sebouh137/KiCadProjects/PrototypeSingleHexTileLarge_6mmSiPM/front.png

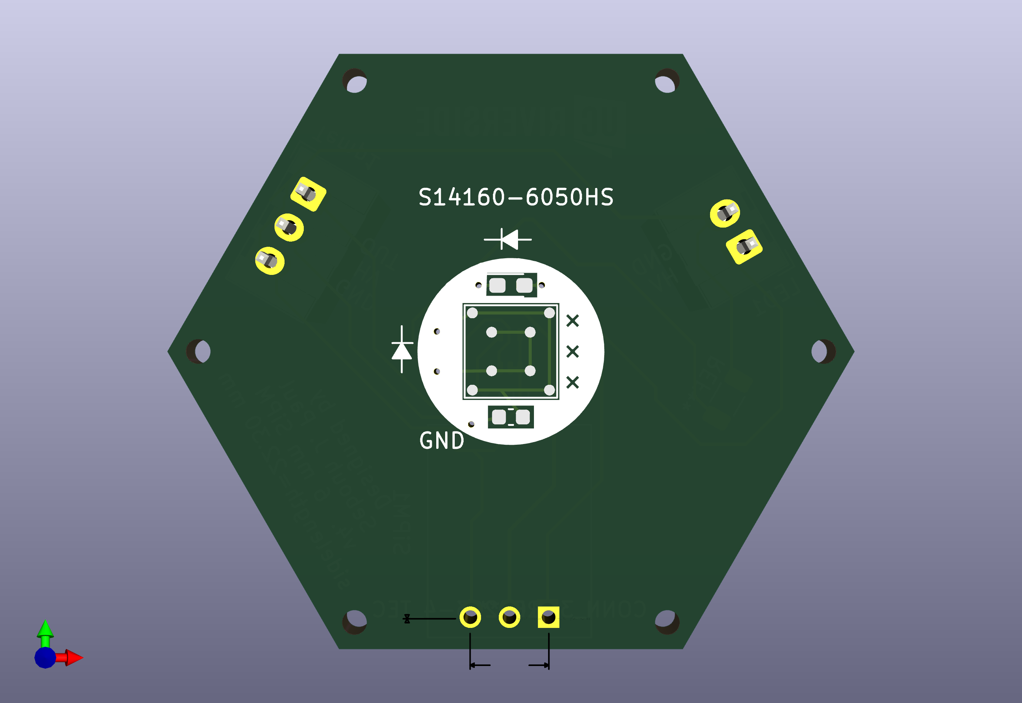
PrototypeSingleHexTileLarge_6mmSiPM/front.png
