sebouh137/KiCadProjects/Condor/back.png

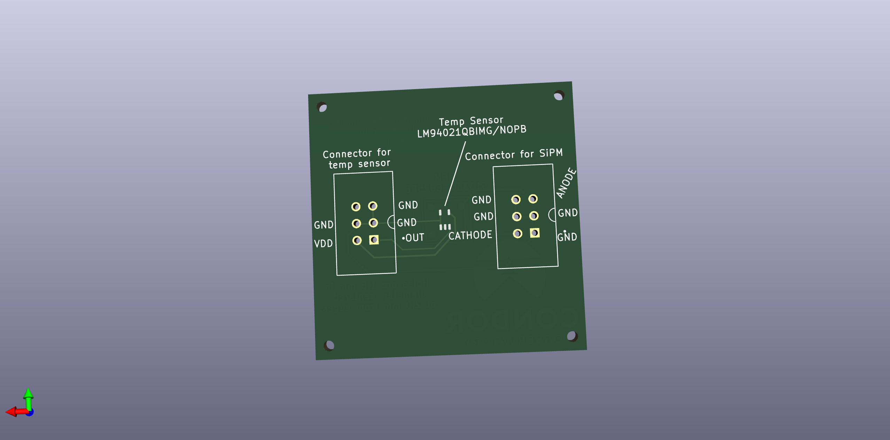
Condor/back.png
