sebouh137/KiCadProjects/3x3_6mmSiPMs/back.png

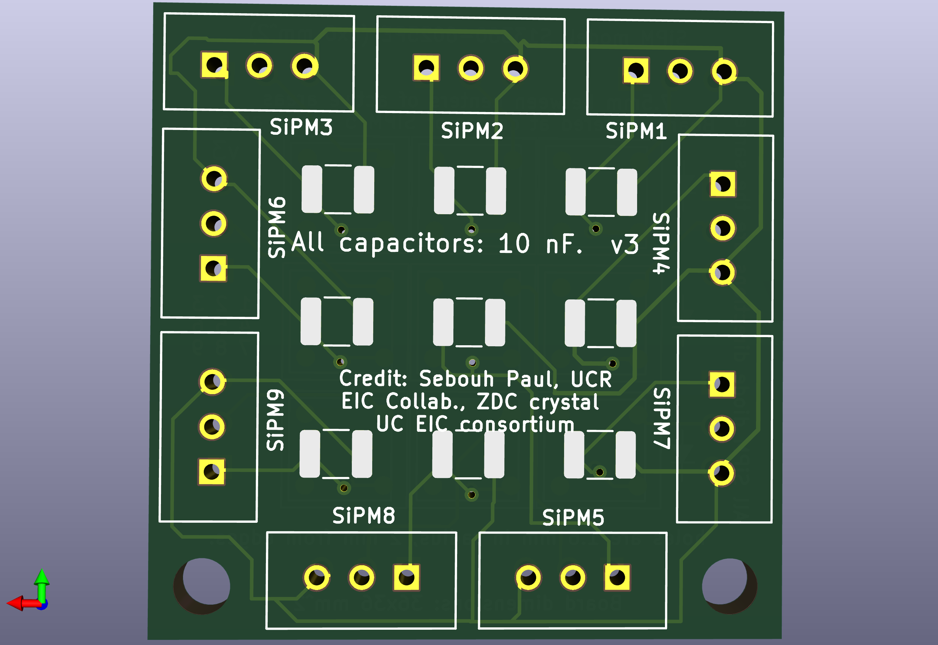
3x3_6mmSiPMs/back.png
