sebouh137/KiCadProjects/3x3_6mmSiPMs/front.png

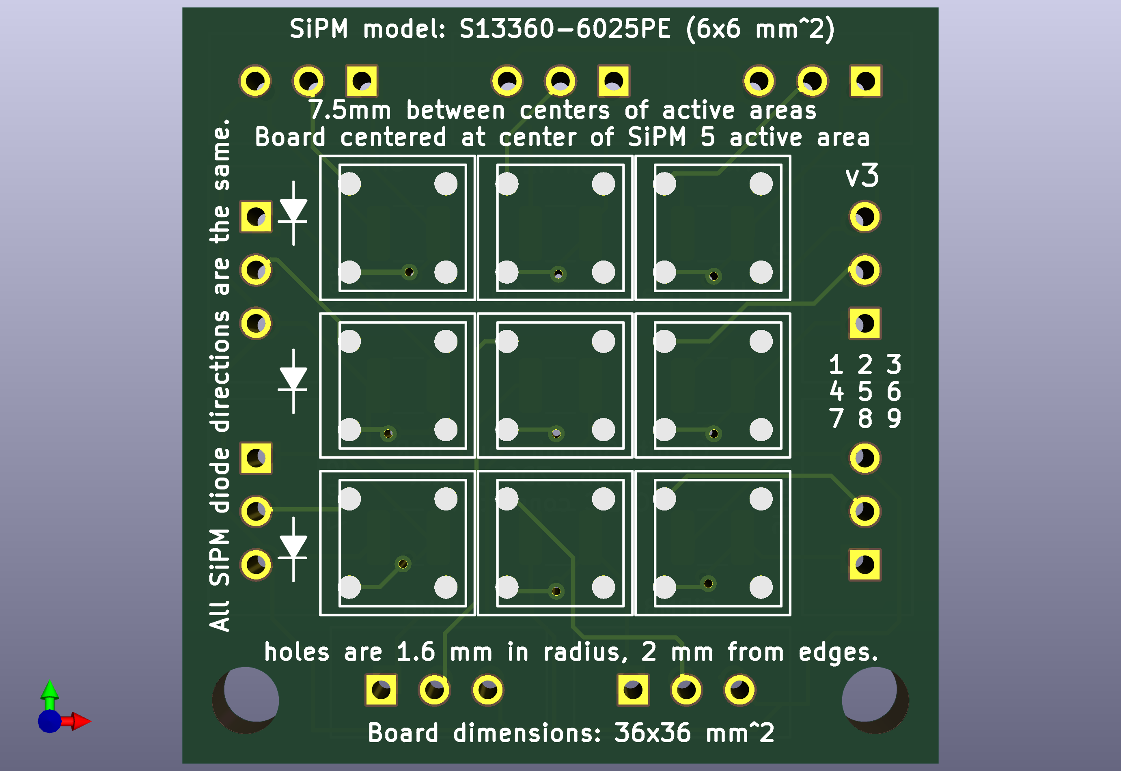
3x3_6mmSiPMs/front.png
