sebouh137/KiCadProjects/ConcentratorBoardForOctagon/back.png

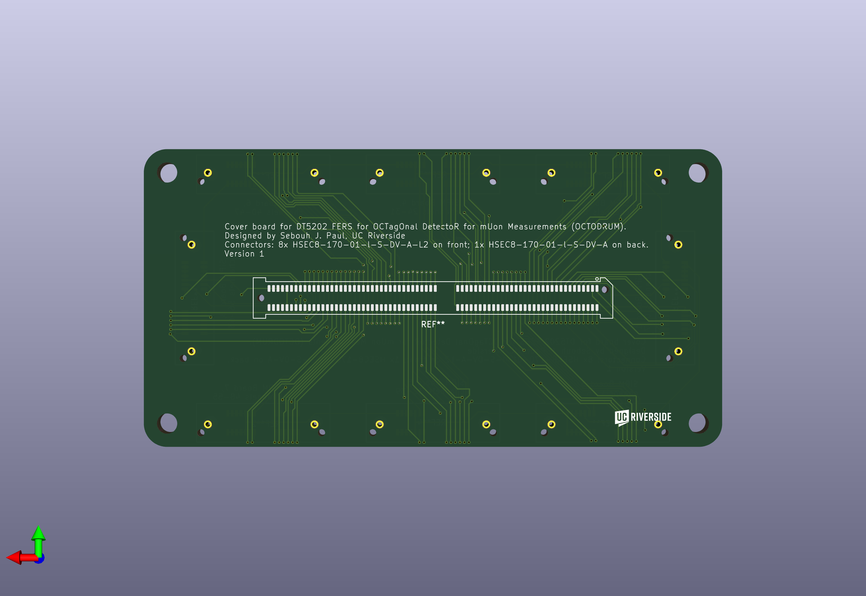
ConcentratorBoardForOctagon/back.png
