sebouh137/KiCadProjects/ConcentratorBoardForOctagon/front.png

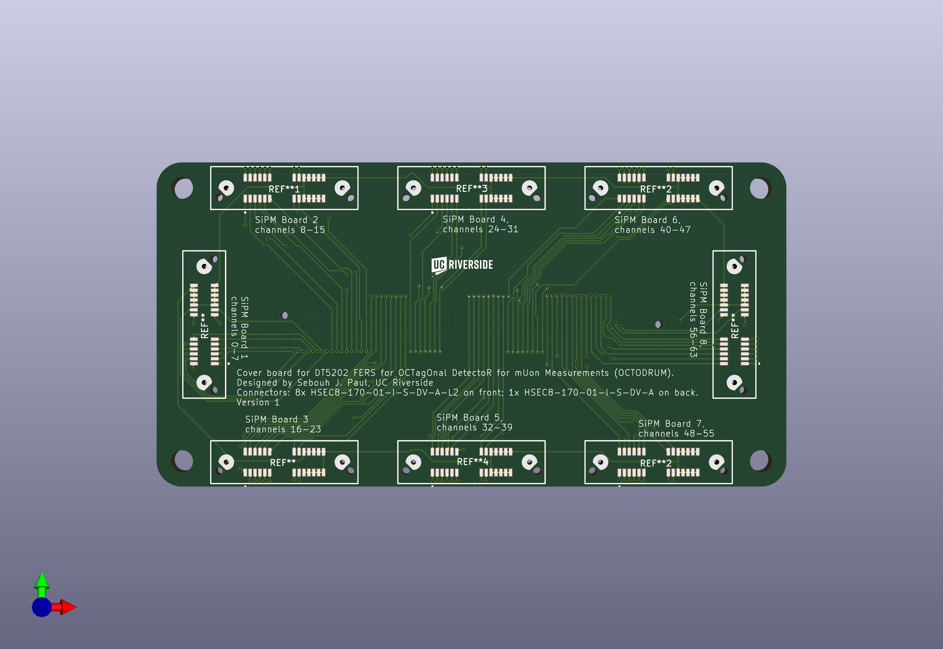
ConcentratorBoardForOctagon/front.png
