sebouh137/KiCadProjects/Condor/front.png

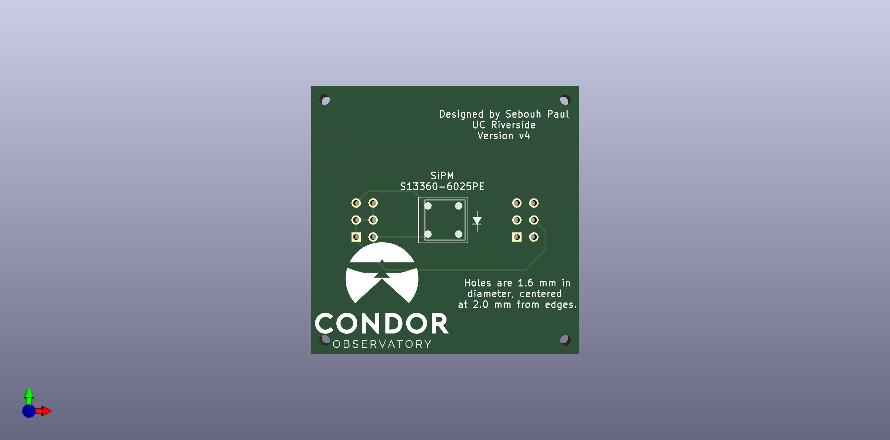
Condor/front.png
