sebouh137/KiCadProjects/Ecal2.5x2.5cm/back.png

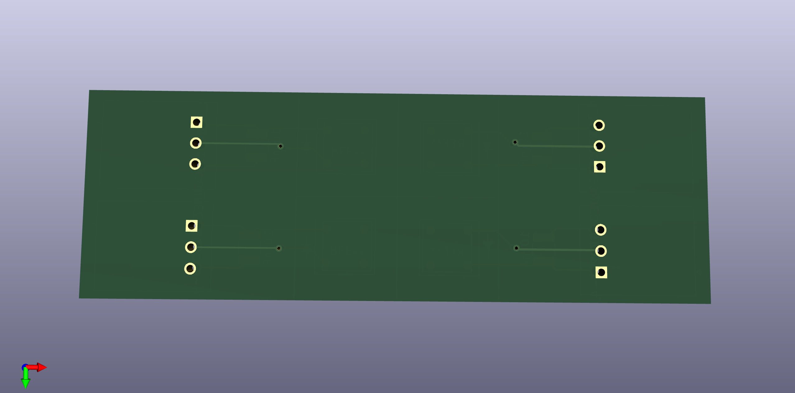
Ecal2.5x2.5cm/back.png
