sebouh137/KiCadProjects/Ecal2.5x2.5cm/front.png

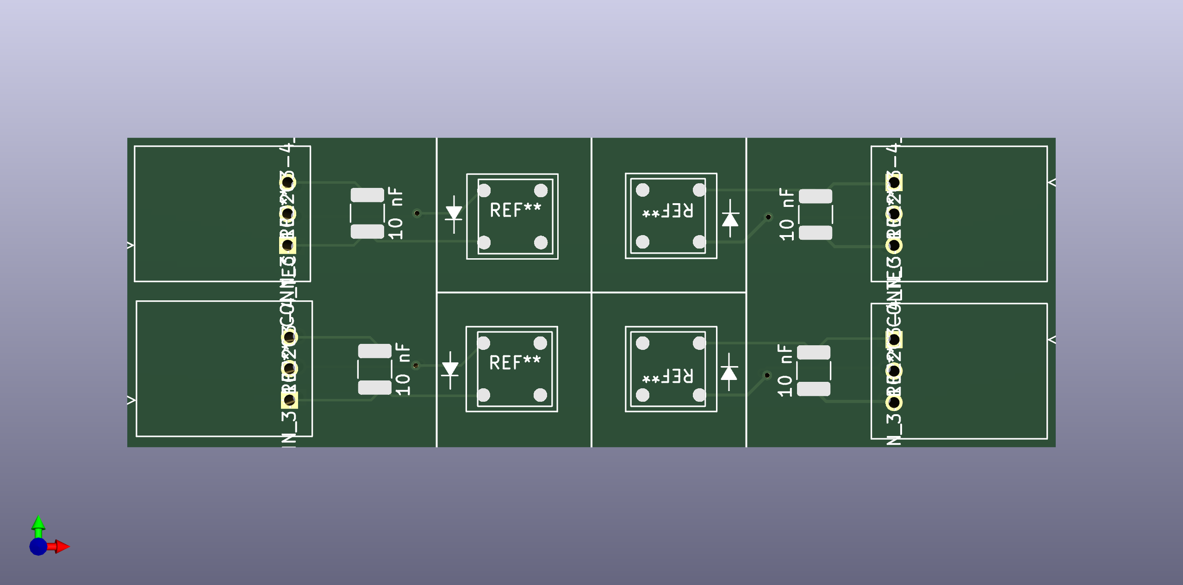
Ecal2.5x2.5cm/front.png
