sebouh137/KiCadProjects/FCAL/back.png

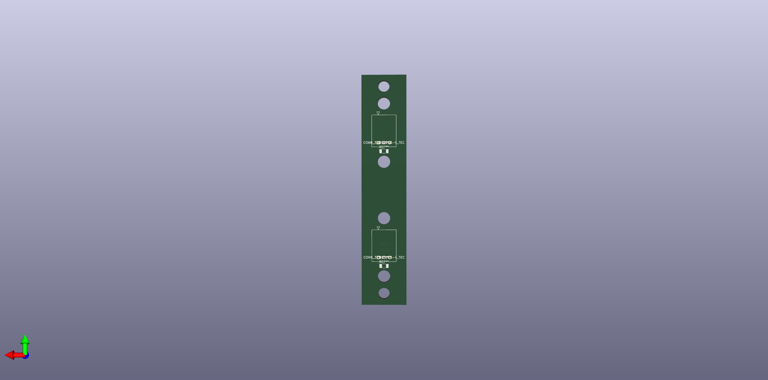
FCAL/back.png
