sebouh137/KiCadProjects/InverterBoard/back.png

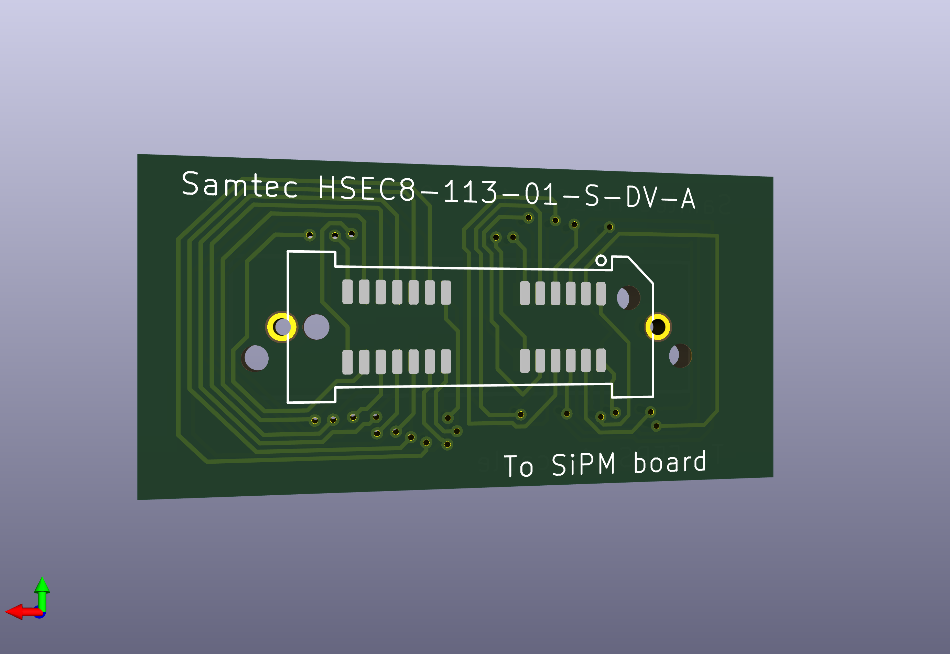
InverterBoard/back.png
