sebouh137/KiCadProjects/InverterBoard/front.png

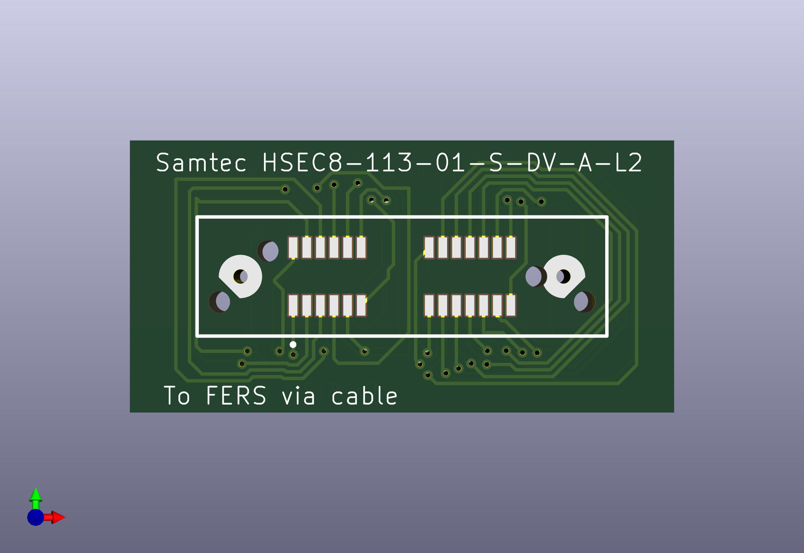
InverterBoard/front.png
