sebouh137/KiCadProjects/IV Board/back.png

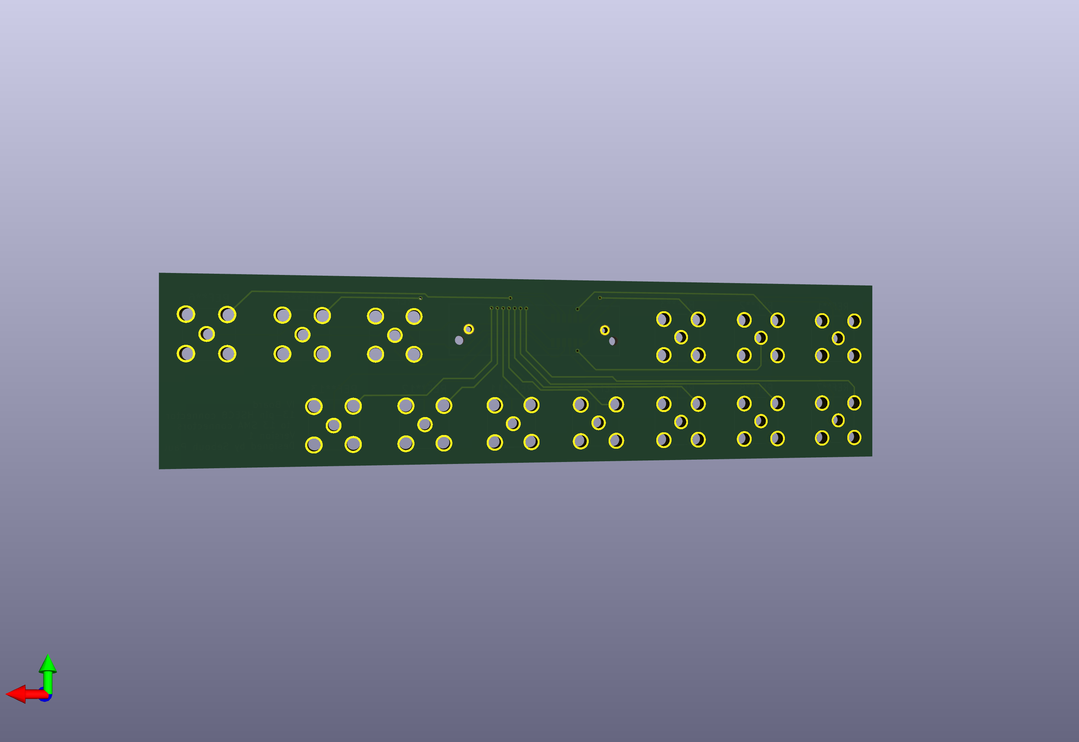
IV Board/back.png
