sebouh137/KiCadProjects/IV Board/front.png

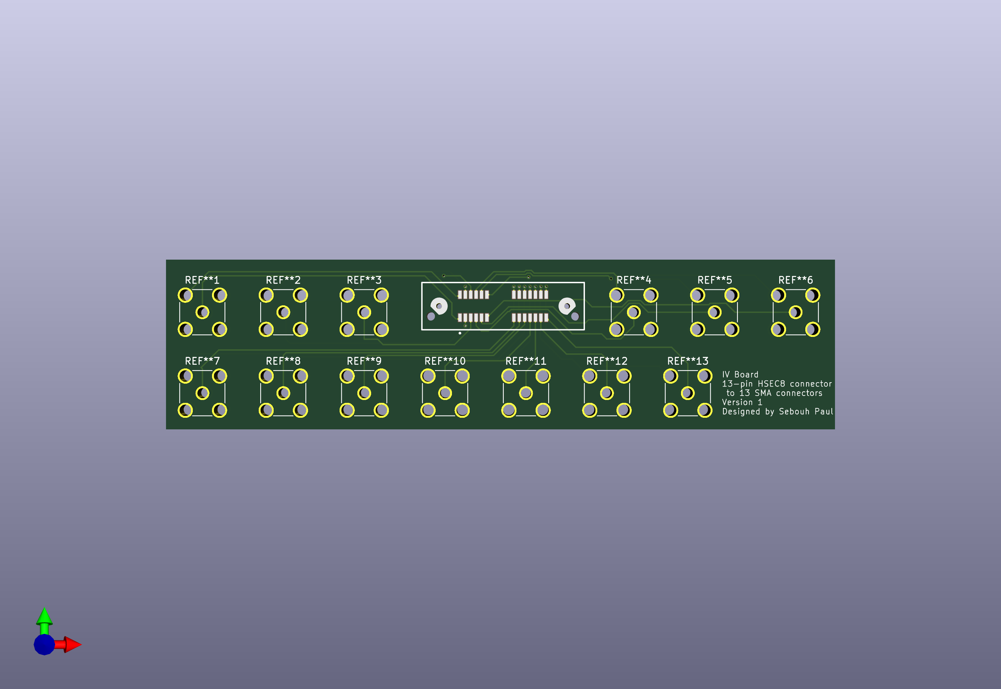
IV Board/front.png
