sebouh137/KiCadProjects/OctagonPanels/back.png

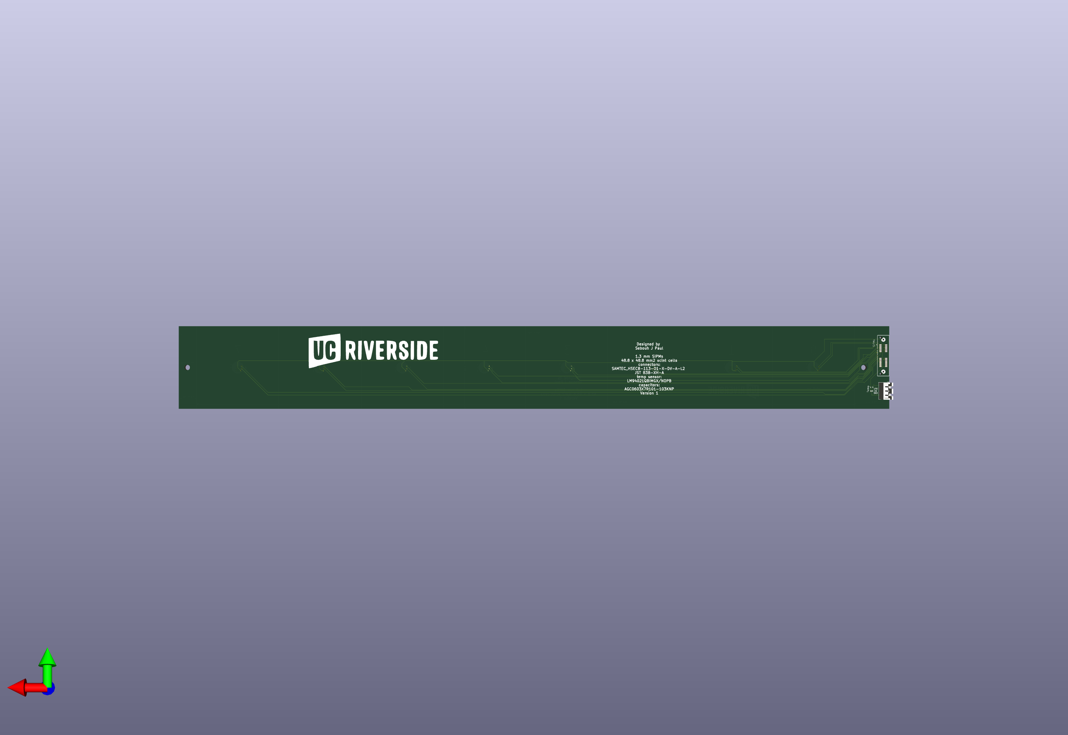
OctagonPanels/back.png
