sebouh137/KiCadProjects/PrototypeSingleHexTileLarge_1.3mmSiPM/back.png

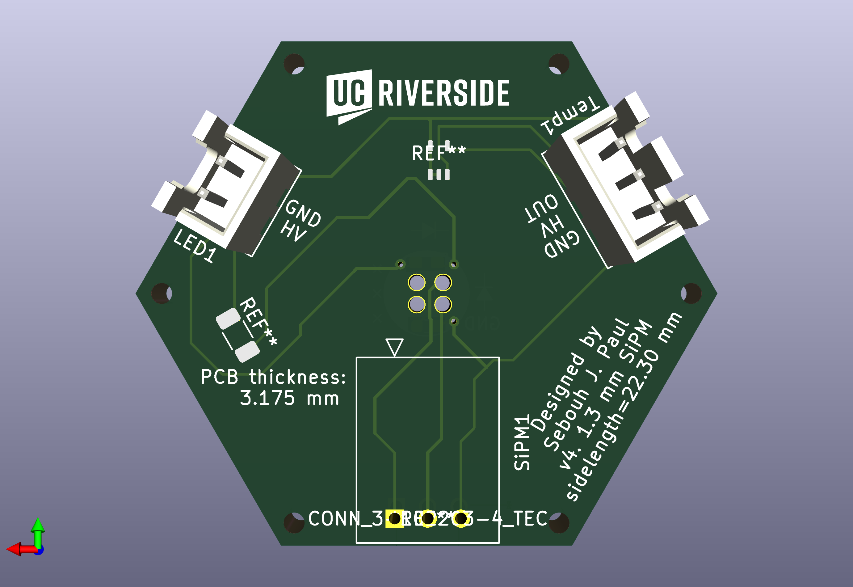
PrototypeSingleHexTileLarge_1.3mmSiPM/back.png
