sebouh137/KiCadProjects/PrototypeSingleHexTileLarge_1.3mmSiPM/front.png

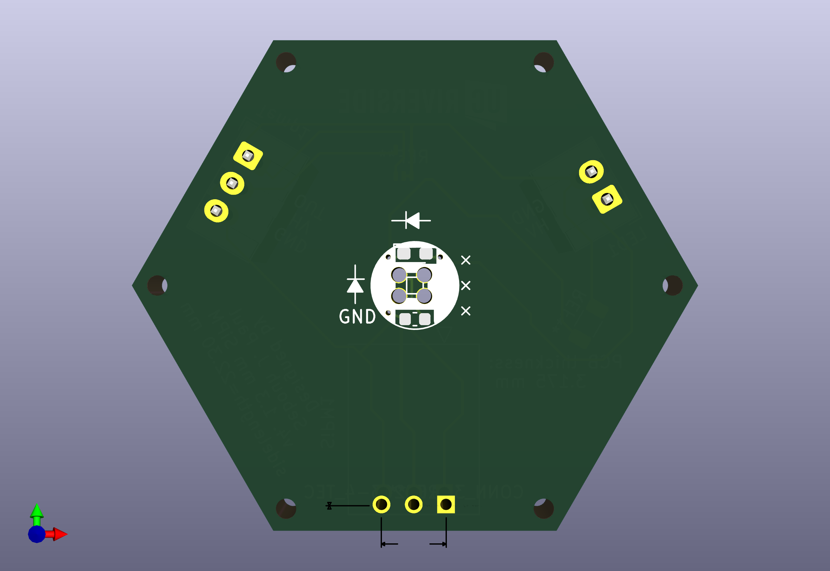
PrototypeSingleHexTileLarge_1.3mmSiPM/front.png
