sebouh137/KiCadProjects/PrototypeSingleHexTileLarge_6mmSiPM/ back.png

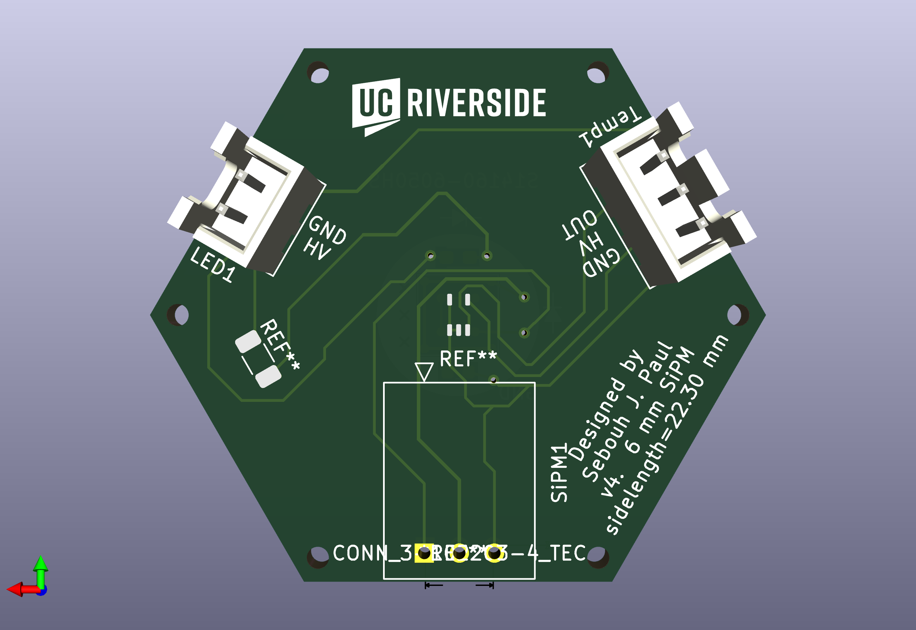
PrototypeSingleHexTileLarge_6mmSiPM/ back.png
