sebouh137/KiCadProjects/RibbonConnectorBoard/back.png

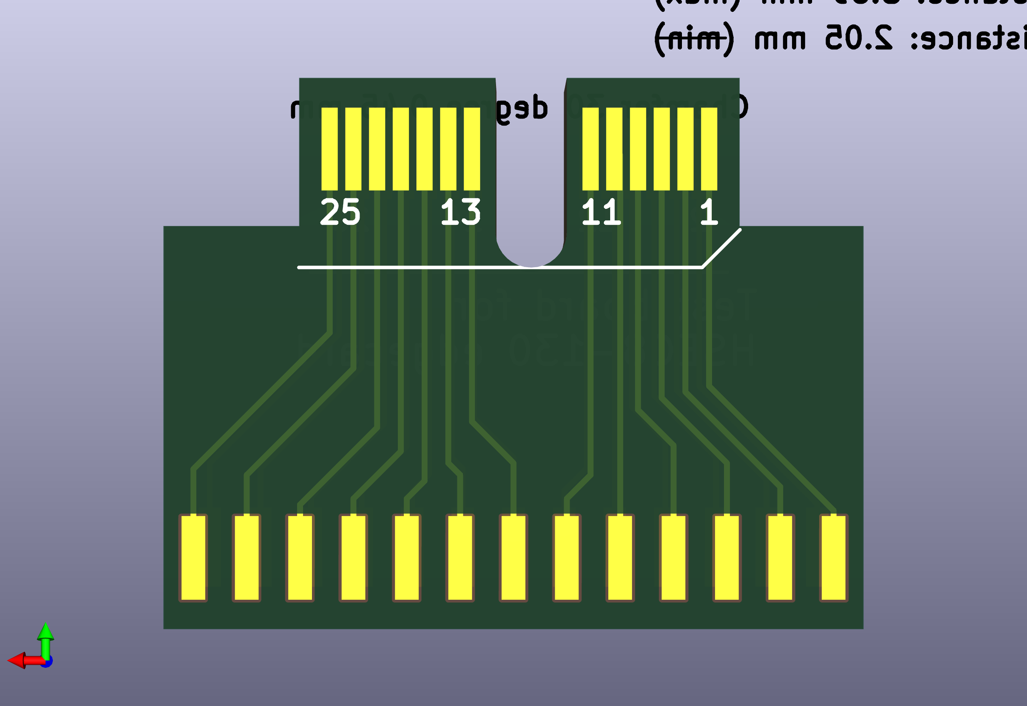
RibbonConnectorBoard/back.png
