sebouh137/KiCadProjects/RibbonConnectorBoard/front.png

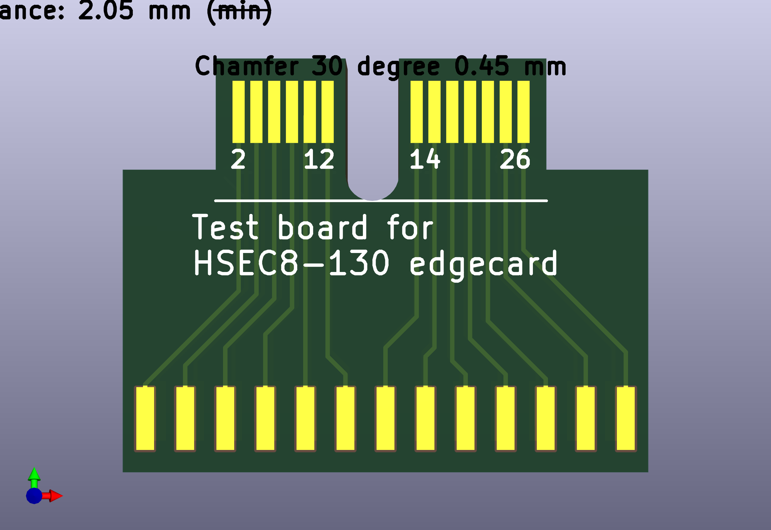
RibbonConnectorBoard/front.png
