sebouh137/KiCadProjects/ZDC_Prototype/EvenLayers_1.3mm_SiPM/back.png

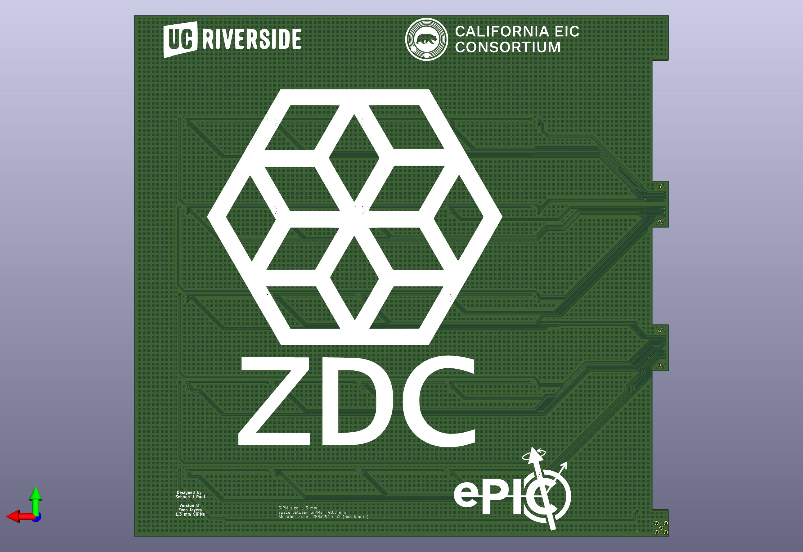
ZDC_Prototype/EvenLayers_1.3mm_SiPM/back.png
