sebouh137/KiCadProjects/ZDC_Prototype/EvenLayers_1.3mm_SiPM/front.png

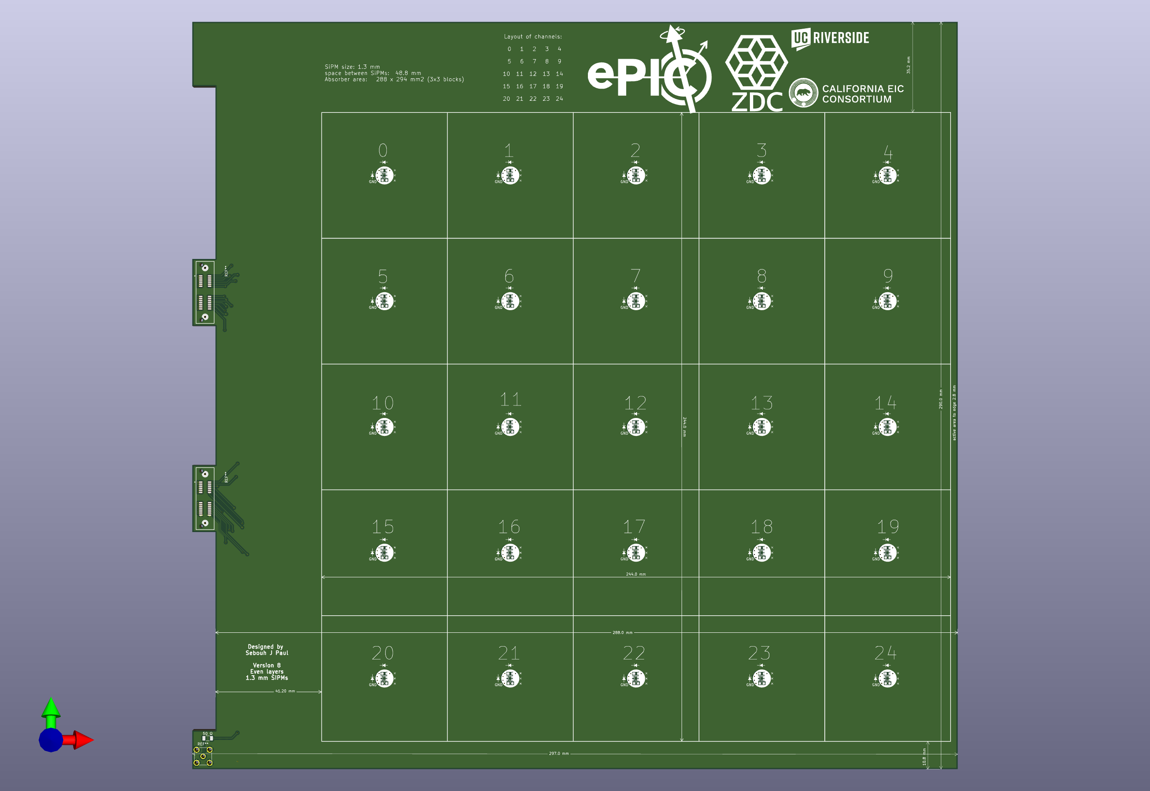
ZDC_Prototype/EvenLayers_1.3mm_SiPM/front.png
