sebouh137/KiCadProjects/ZDC_Prototype/EvenLayers_3.0mm_SiPM/back.png

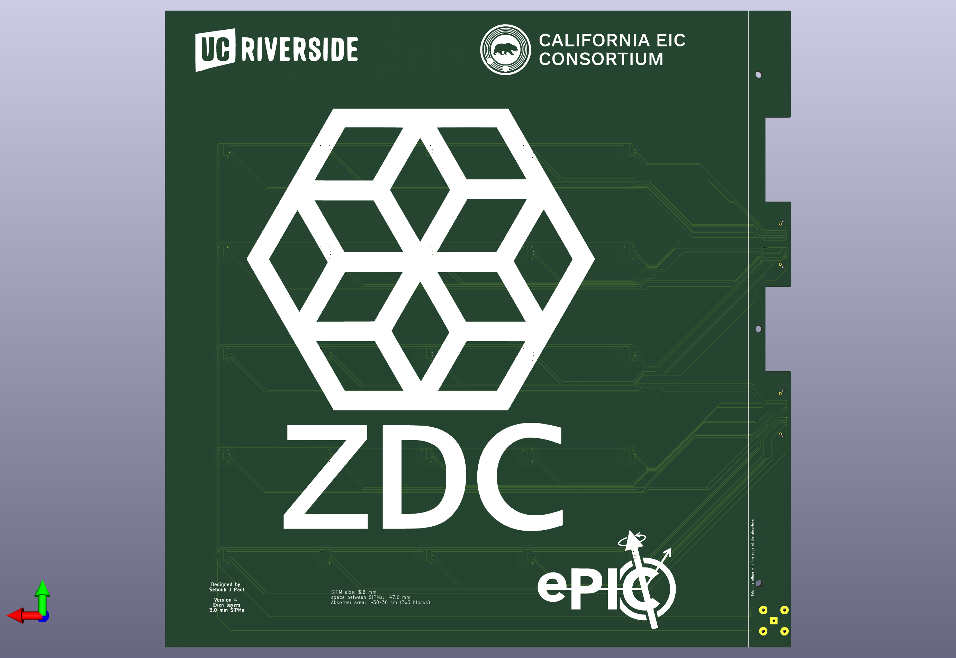
ZDC_Prototype/EvenLayers_3.0mm_SiPM/back.png
