sebouh137/KiCadProjects/ZDC_Prototype/EvenLayers_3.0mm_SiPM/front.png

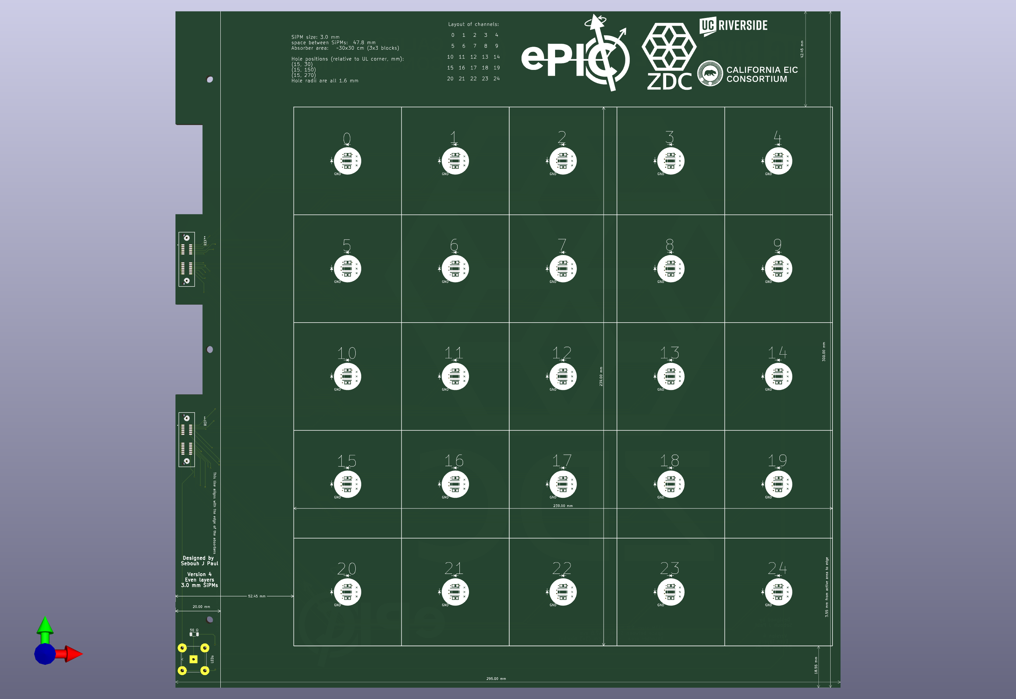
ZDC_Prototype/EvenLayers_3.0mm_SiPM/front.png
