sebouh137/KiCadProjects/ZDC_Prototype/OddLayers_1.3mm_SiPM/back.png

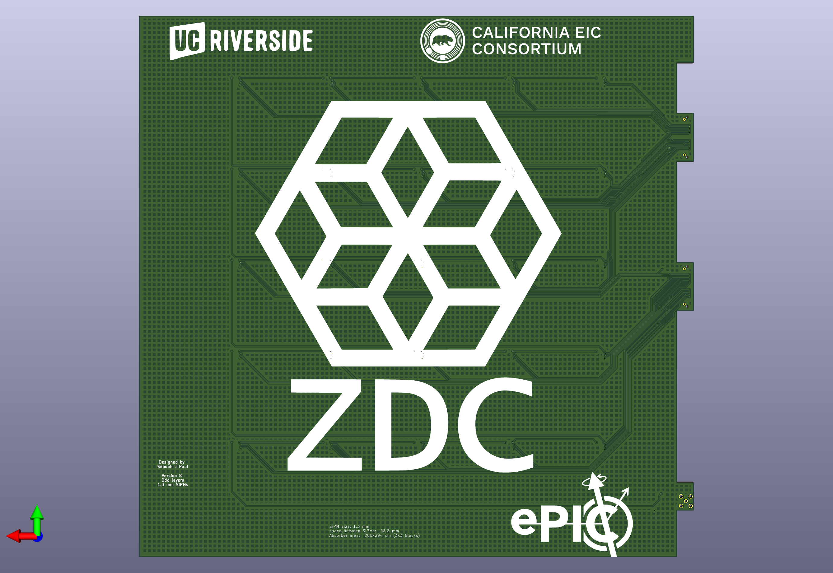
ZDC_Prototype/OddLayers_1.3mm_SiPM/back.png
