sebouh137/KiCadProjects/ZDC_Prototype/OddLayers_1.3mm_SiPM/front.png

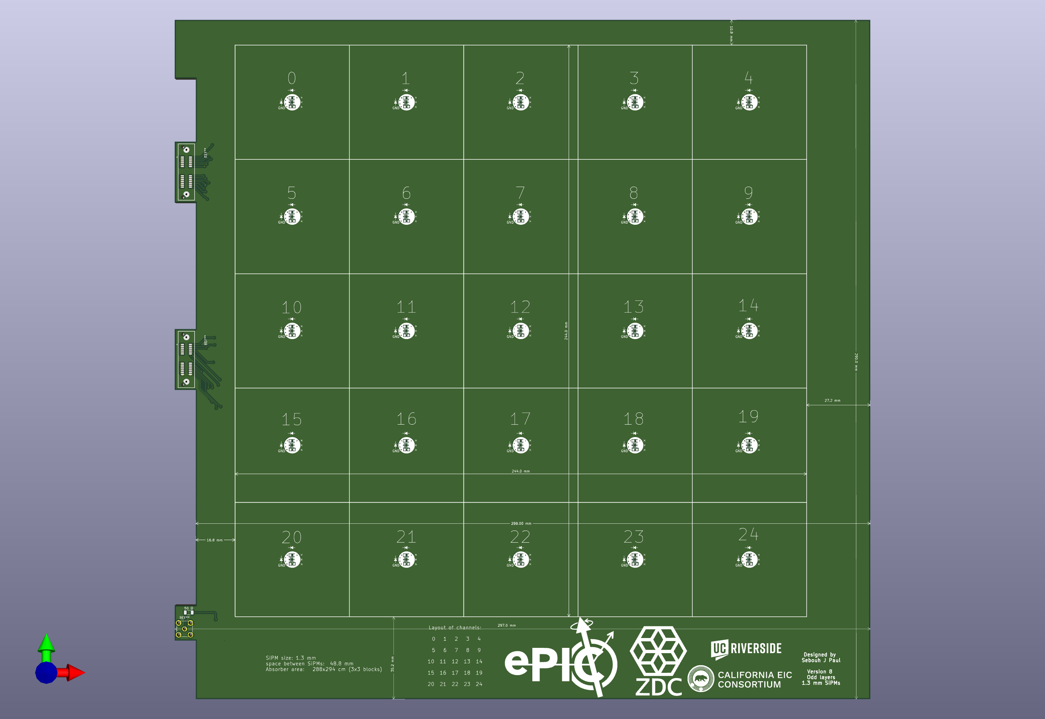
ZDC_Prototype/OddLayers_1.3mm_SiPM/front.png
