sebouh137/KiCadProjects/ZDC_Prototype/OddLayers_3.0mm_SiPM/front.png

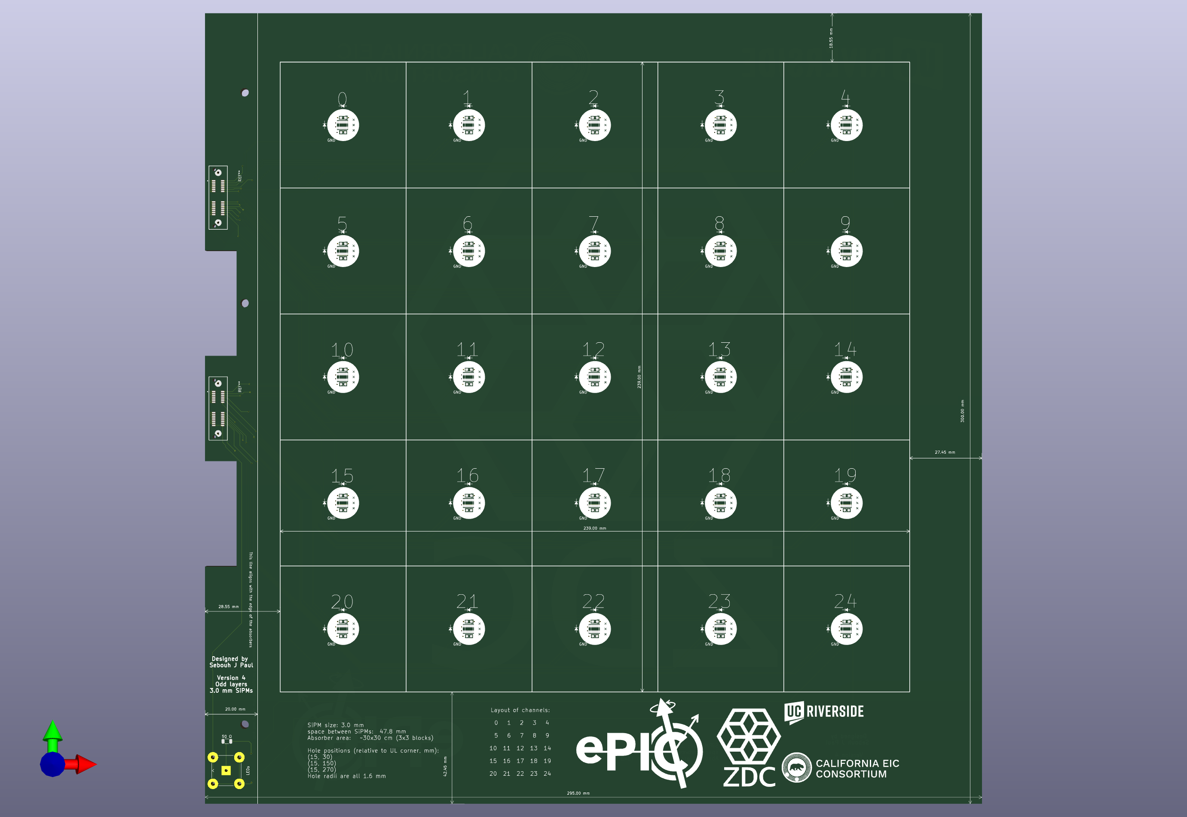
ZDC_Prototype/OddLayers_3.0mm_SiPM/front.png
