sebouh137/KiCadProjects/3x3_6mmSiPMs/3x3_6mSiPMs.step

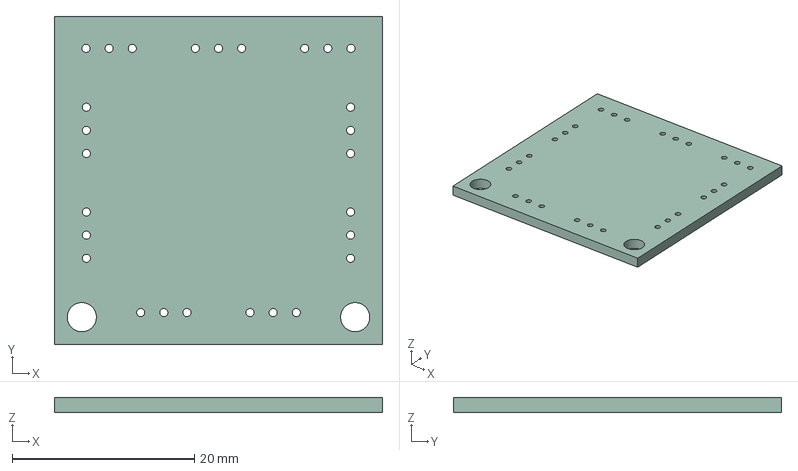
[picture p29: CAD file, 2024-08-05]
3x3_6mmSiPMs/3x3_6mSiPMs.step
36.0 x 36.0 x 1.60 mm
