sebouh137/KiCadProjects/ConcentratorBoardForOctagon/ConcentratorBoardOctagon.step

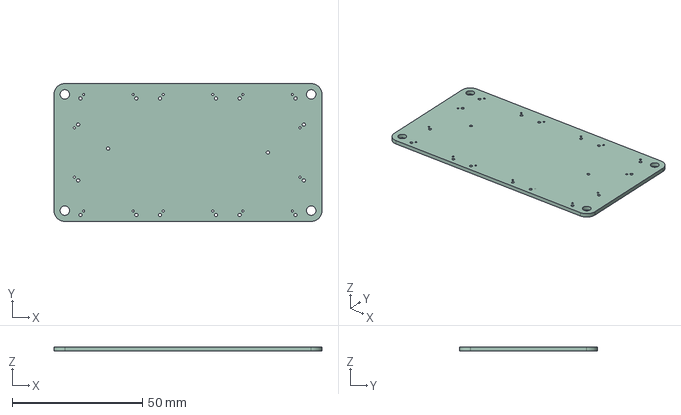
[picture p30: CAD file, 2025-02-24]
ConcentratorBoardForOctagon/ConcentratorBoardOctagon.step
103.0 x 53.0 x 1.60 mm
