sebouh137/KiCadProjects/FCAL/FCAL.step

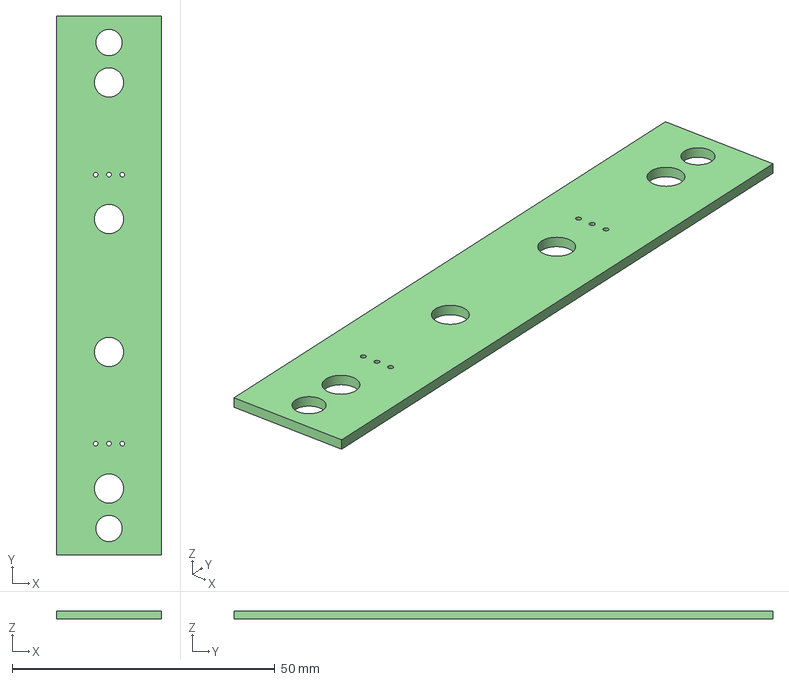
[picture p31: CAD file, 2022-11-16]
FCAL/FCAL.step
20.0 x 102.6 x 1.60 mm
