sebouh137/KiCadProjects/IV Board/Dummy Board.step

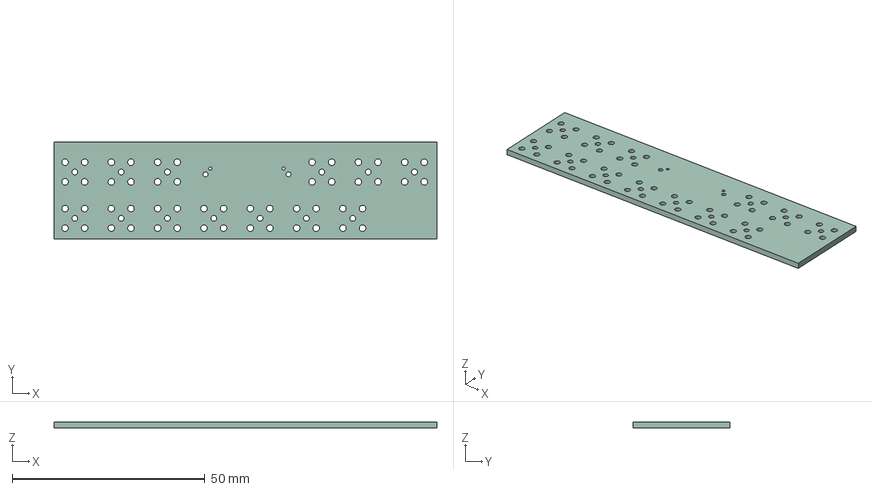
[picture p32: CAD file, 2024-11-20]
IV Board/Dummy Board.step
99.2 x 25.2 x 1.60 mm
