sebouh137/KiCadProjects/PrototypeHexboardB/Hexboard.step

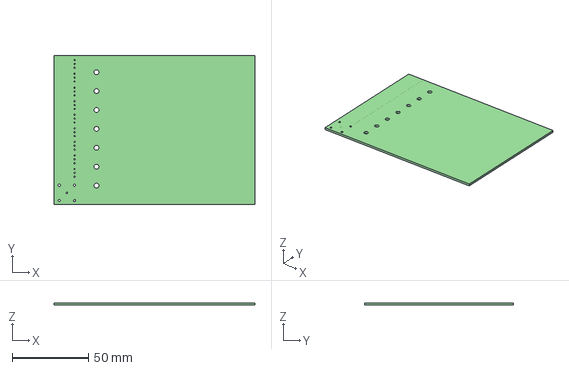
[picture p33: CAD file, 2023-03-30]
PrototypeHexboardB/Hexboard.step
131.9 x 98.0 x 1.60 mm
