sebouh137/KiCadProjects/PrototypeSingleHexTileLarge_1.3mmSiPM/Untitled.step

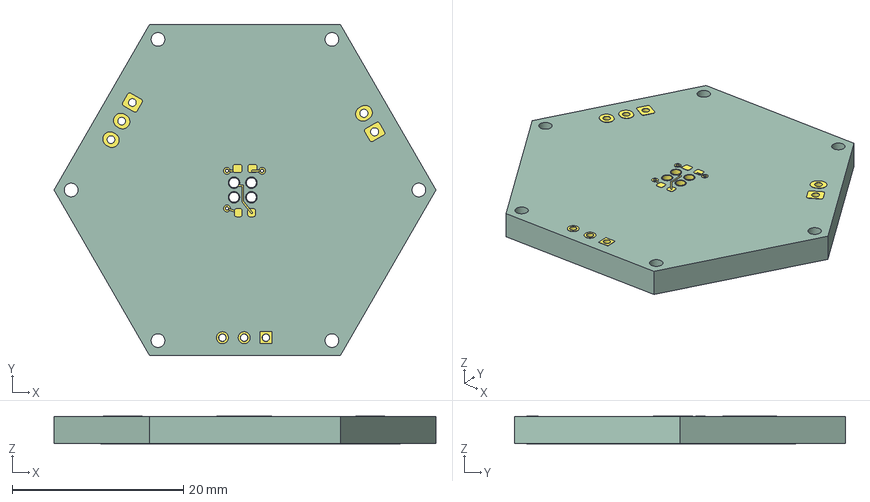
[picture p34: CAD file, 2024-08-06]
PrototypeSingleHexTileLarge_1.3mmSiPM/Untitled.step
44.6 x 38.6 x 3.25 mm
Untitled_track_1
Untitled_track_2
Untitled_track_3
Untitled_track_4
Untitled_track_5
Untitled_track_6
Untitled_track_7
Untitled_track_8
Untitled_track_9
Untitled_track_10
Untitled_track_11
Untitled_track_12
Untitled_track_13
Untitled_track_14
Untitled_track_15
Untitled_track_16
Untitled_track_17
Untitled_track_18
Untitled_track_19
Untitled_track_20
Untitled_track_21
Untitled_track_22
Untitled_track_23
Untitled_track_24
Untitled_track_25
Untitled_track_26
Untitled_track_27
Untitled_track_28
Untitled_track_29
Untitled_track_30
Untitled_track_31
Untitled_track_32
Untitled_track_33
Untitled_track_34
Untitled_track_35
Untitled_track_36
Untitled_track_37
Untitled_track_38
Untitled_track_39
Untitled_track_40
Untitled_track_41
Untitled_track_42
Untitled_track_43
Untitled_track_44
Untitled_track_45
Untitled_track_46
Untitled_track_47
Untitled_track_48
Untitled_track_49
Untitled_track_50
Untitled_track_51
Untitled_track_52
Untitled_track_53
Untitled_track_54
Untitled_track_55
Untitled_track_56
Untitled_track_57
Untitled_track_58
Untitled_track_59
Untitled_track_60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
