sebouh137/KiCadProjects/PrototypeSingleHexTileLarge_6mmSiPM/Untitled.step

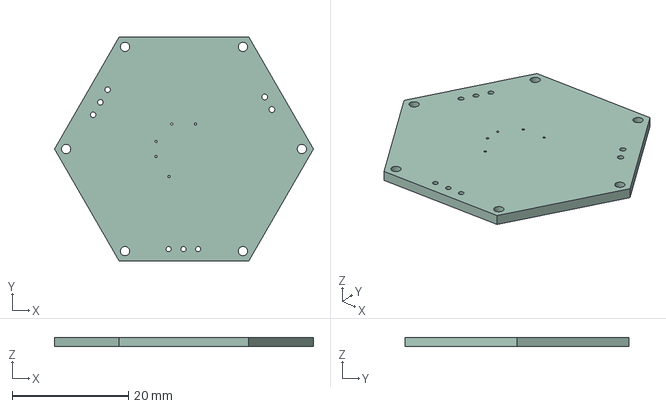
[picture p35: CAD file, 2024-08-19]
PrototypeSingleHexTileLarge_6mmSiPM/Untitled.step
44.6 x 38.6 x 1.60 mm
