sebouh137/KiCadProjects/RibbonConnectorBoard/Dummy Board.step

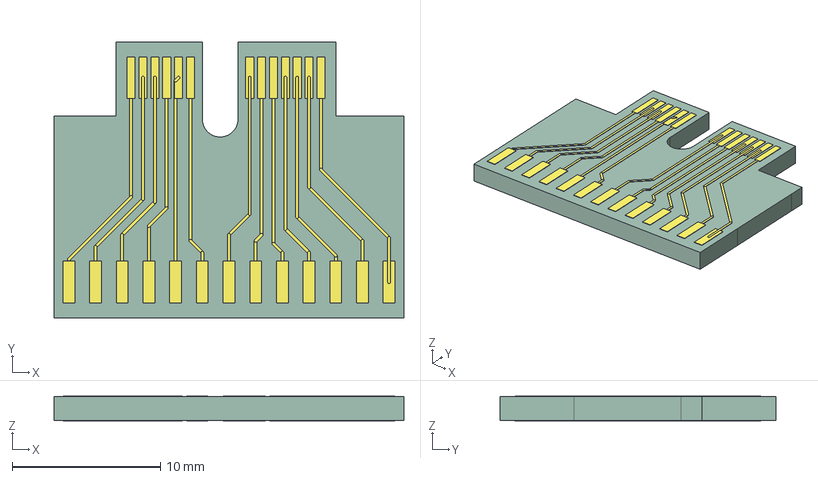
[picture p36: CAD file, 2024-11-20]
RibbonConnectorBoard/Dummy Board.step
23.6 x 18.6 x 1.67 mm
_autosave-Dummy Board_track_1
_autosave-Dummy Board_track_2
_autosave-Dummy Board_track_3
_autosave-Dummy Board_track_4
_autosave-Dummy Board_track_5
_autosave-Dummy Board_track_6
_autosave-Dummy Board_track_7
_autosave-Dummy Board_track_8
_autosave-Dummy Board_track_9
_autosave-Dummy Board_track_10
_autosave-Dummy Board_track_11
_autosave-Dummy Board_track_12
_autosave-Dummy Board_track_13
_autosave-Dummy Board_track_14
_autosave-Dummy Board_track_15
_autosave-Dummy Board_track_16
_autosave-Dummy Board_track_17
_autosave-Dummy Board_track_18
_autosave-Dummy Board_track_19
_autosave-Dummy Board_track_20
_autosave-Dummy Board_track_21
_autosave-Dummy Board_track_22
_autosave-Dummy Board_track_23
_autosave-Dummy Board_track_24
_autosave-Dummy Board_track_25
_autosave-Dummy Board_track_26
_autosave-Dummy Board_track_27
_autosave-Dummy Board_track_28
_autosave-Dummy Board_track_29
_autosave-Dummy Board_track_30
_autosave-Dummy Board_track_31
_autosave-Dummy Board_track_32
_autosave-Dummy Board_track_33
_autosave-Dummy Board_track_34
_autosave-Dummy Board_track_35
_autosave-Dummy Board_track_36
_autosave-Dummy Board_track_37
_autosave-Dummy Board_track_38
_autosave-Dummy Board_track_39
_autosave-Dummy Board_track_40
_autosave-Dummy Board_track_41
_autosave-Dummy Board_track_42
_autosave-Dummy Board_track_43
_autosave-Dummy Board_track_44
_autosave-Dummy Board_track_45
_autosave-Dummy Board_track_46
_autosave-Dummy Board_track_47
_autosave-Dummy Board_track_48
_autosave-Dummy Board_track_49
_autosave-Dummy Board_track_50
_autosave-Dummy Board_track_51
_autosave-Dummy Board_track_52
_autosave-Dummy Board_track_53
_autosave-Dummy Board_track_54
_autosave-Dummy Board_track_55
_autosave-Dummy Board_track_56
_autosave-Dummy Board_track_57
_autosave-Dummy Board_track_58
_autosave-Dummy Board_track_59
_autosave-Dummy Board_track_60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
