sebouh137/KiCadProjects/ZDC_Prototype/EvenLayers_1.3mm_SiPM/EvenLayers_1.3mm_SiPM.step

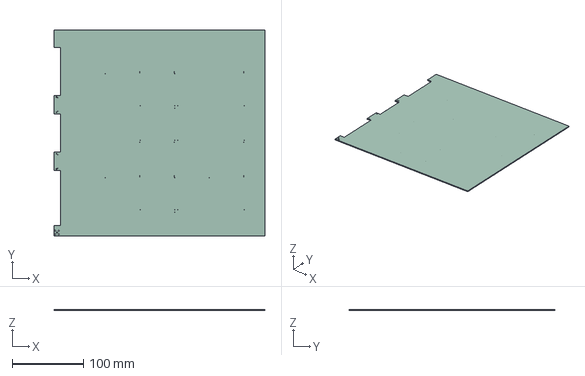
[picture p37: CAD file, 2025-02-26]
ZDC_Prototype/EvenLayers_1.3mm_SiPM/EvenLayers_1.3mm_SiPM.step
297.0 x 290.0 x 1.60 mm
