sebouh137/KiCadProjects/(list of files, cad)

Other CAD files:
ZDC_Prototype/OddLayers_1.3mm_SiPM/OddLayers_1.3mm_SiPM.step
