sebouh137/KiCadProjects/(commit log)

2022-11-16 square and flower boards at V4
    [Untitled-B_Cu.gbr, Untitled-B_Mask.gbr, Untitled-B_Paste.gbr, Untitled-B_Silkscreen.gbr, Untitled-Edge_Cuts.gbr, Untitled-F_Cu.gbr, Untitled-F_Mask.gbr, Untitled-F_Paste.gbr]
2022-11-16 added front and back screenshots of the boards for CONDOR and the FCAL
2022-11-16 Added zip files
    [Untitled-B_Cu.gbr, Untitled-B_Mask.gbr, Untitled-B_Paste.gbr, Untitled-B_Silkscreen.gbr, Untitled-Edge_Cuts.gbr, Untitled-F_Cu.gbr, Untitled-F_Mask.gbr, Untitled-F_Paste.gbr]
2022-11-17 v1 of the single hex (3 sizes) and single pent boards
    [Untitled-B_Cu.gbr, Untitled-B_Mask.gbr, Untitled-B_Paste.gbr, Untitled-B_Silkscreen.gbr, Untitled-Edge_Cuts.gbr, Untitled-F_Cu.gbr, Untitled-F_Mask.gbr, Untitled-F_Paste.gbr]
2022-12-07 v5 of the prototype hexboard and squareboards: added label to capacitors and resistors; moved temperature sensors to periphery; added 0.1 mm back to top and bottom of boards
    [Hexboard.step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]
2022-12-28 updated condor board
    [Condor-B_Cu.gbr, Condor-B_Mask.gbr, Condor-B_Paste.gbr, Condor-B_Silkscreen.gbr, Condor-Edge_Cuts.gbr, Condor-F_Cu.gbr, Condor-F_Mask.gbr, Condor-F_Paste.gbr]
2022-12-29 updated condor board (v3, with 2 6-pin connectors, matching the uDAQ
    [Condor-B_Cu.gbr, Condor-B_Mask.gbr, Condor-B_Paste.gbr, Condor-B_Silkscreen.gbr, Condor-Edge_Cuts.gbr, Condor-F_Cu.gbr, Condor-F_Mask.gbr, Condor-F_Paste.gbr]
2022-12-29 updated condor board (v4, with 2 6-pin connectors on left and right of center, matching the physical positions of the uDAQ pins)
    [Condor-B_Cu.gbr, Condor-B_Mask.gbr, Condor-B_Paste.gbr, Condor-B_Silkscreen.gbr, Condor-Edge_Cuts.gbr, Condor-F_Cu.gbr, Condor-F_Mask.gbr, Condor-F_Paste.gbr]
2022-12-29 updated condor board; added an additional label
    [Condor-B_Cu.gbr, Condor-B_Mask.gbr, Condor-B_Paste.gbr, Condor-B_Silkscreen.gbr, Condor-Edge_Cuts.gbr, Condor-F_Cu.gbr, Condor-F_Mask.gbr, Condor-F_Paste.gbr]
2022-12-29 updated condor board. v4: added a notch to indicate the polarity of the connector
    [Condor-B_Cu.gbr, Condor-B_Mask.gbr, Condor-B_Paste.gbr, Condor-B_Silkscreen.gbr, Condor-Edge_Cuts.gbr, Condor-F_Cu.gbr, Condor-F_Mask.gbr, Condor-F_Paste.gbr]
2022-12-31 v6 of square and hex boards: traces in back in the area where the scints are to be placed.
    [Untitled-B_Cu.gbr, Untitled-B_Mask.gbr, Untitled-B_Paste.gbr, Untitled-B_Silkscreen.gbr, Untitled-Edge_Cuts.gbr, Untitled-F_Cu.gbr, Untitled-F_Mask.gbr, Untitled-F_Paste.gbr]
2023-03-28 PrototypeHexboard: smaller SiPM, silkscreen same size as large dimple option
    [Untitled-B_Cu.gbr, Untitled-B_Mask.gbr, Untitled-B_Paste.gbr, Untitled-B_Silkscreen.gbr, Untitled-Edge_Cuts.gbr, Untitled-F_Cu.gbr, Untitled-F_Mask.gbr, Untitled-F_Paste.gbr]
2023-03-28 PrototypeHexboard: smaller SiPM, silkscreen same size as large dimple option. Corrected version. V7
    [Untitled-B_Cu.gbr, Untitled-B_Mask.gbr, Untitled-B_Paste.gbr, Untitled-B_Silkscreen.gbr, Untitled-Edge_Cuts.gbr, Untitled-F_Cu.gbr, Untitled-F_Mask.gbr, Untitled-F_Paste.gbr]
2023-03-28 PrototypeHexboard: move LEDs to fit inside dimple
    [Untitled-B_Cu.gbr, Untitled-B_Mask.gbr, Untitled-B_Paste.gbr, Untitled-B_Silkscreen.gbr, Untitled-Edge_Cuts.gbr, Untitled-F_Cu.gbr, Untitled-F_Mask.gbr, Untitled-F_Paste.gbr]
2023-03-30 added SiPM specification in silkscreen
    [Hexboard.step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]
2023-04-06 added triple flower board
    [Untitled-B_Cu.gbr, Untitled-B_Mask.gbr, Untitled-B_Paste.gbr, Untitled-B_Silkscreen.gbr, Untitled-Edge_Cuts.gbr, Untitled-F_Cu.gbr, Untitled-F_Mask.gbr, Untitled-F_Paste.gbr]
2023-06-07 added Ecal 2.5x2.5 cm^2 board
    [Ecal2.5x2.5cm-B_Cu.gbr, Ecal2.5x2.5cm-B_Mask.gbr, Ecal2.5x2.5cm-B_Paste.gbr, Ecal2.5x2.5cm-B_Silkscreen.gbr, Ecal2.5x2.5cm-Edge_Cuts.gbr, Ecal2.5x2.5cm-F_Cu.gbr, Ecal2.5x2.5cm-F_Mask.gbr, Ecal2.5x2.5cm-F_Paste.gbr]
2023-06-07 corrected capacitance in Ecal 2.5x2.5 cm^2 board
    [Ecal2.5x2.5cm-B_Cu.gbr, Ecal2.5x2.5cm-B_Mask.gbr, Ecal2.5x2.5cm-B_Paste.gbr, Ecal2.5x2.5cm-B_Silkscreen.gbr, Ecal2.5x2.5cm-Edge_Cuts.gbr, Ecal2.5x2.5cm-F_Cu.gbr, Ecal2.5x2.5cm-F_Mask.gbr, Ecal2.5x2.5cm-F_Paste.gbr]
2023-06-16 added FDC prototype board
    [Hexboard.step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]
2023-09-14 removed extraneous traces on front of square-cell board
    [Untitled-B_Cu.gbr, Untitled-B_Mask.gbr, Untitled-B_Paste.gbr, Untitled-B_Silkscreen.gbr, Untitled-Edge_Cuts.gbr, Untitled-F_Cu.gbr, Untitled-F_Mask.gbr, Untitled-F_Paste.gbr]
2023-09-21 added PrototypeHexboadB
    [Hexboard.step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]
2024-04-30 v7 square board. 1.3 mm SiPMs, vias inside dimples, and excessive silkscreen removed outside dimple
    [Untitled-B_Cu.gbr, Untitled-B_Mask.gbr, Untitled-B_Paste.gbr, Untitled-B_Silkscreen.gbr, Untitled-Edge_Cuts.gbr, Untitled-F_Cu.gbr, Untitled-F_Mask.gbr, Untitled-F_Paste.gbr]
2024-05-08 created a 5x5 square board, for use with S2 hexplit
    [Untitled-B_Cu.gbr, Untitled-B_Mask.gbr, Untitled-B_Paste.gbr, Untitled-B_Silkscreen.gbr, Untitled-Edge_Cuts.gbr, Untitled-F_Cu.gbr, Untitled-F_Mask.gbr, Untitled-F_Paste.gbr]
2024-05-08 updated 5x5 square board based on Miguel's feedback
    [Untitled-B_Cu.gbr, Untitled-B_Mask.gbr, Untitled-B_Paste.gbr, Untitled-B_Silkscreen.gbr, Untitled-Edge_Cuts.gbr, Untitled-F_Cu.gbr, Untitled-F_Mask.gbr, Untitled-F_Paste.gbr]
2024-05-08 updated 5x5 square board; added ePIC logo
    [Untitled-B_Cu.gbr, Untitled-B_Mask.gbr, Untitled-B_Paste.gbr, Untitled-B_Silkscreen.gbr, Untitled-Edge_Cuts.gbr, Untitled-F_Cu.gbr, Untitled-F_Mask.gbr, Untitled-F_Paste.gbr]
2024-05-08 updated 5x5 square board; added dimensions
    [Untitled-B_Cu.gbr, Untitled-B_Mask.gbr, Untitled-B_Paste.gbr, Untitled-B_Silkscreen.gbr, Untitled-Edge_Cuts.gbr, Untitled-F_Cu.gbr, Untitled-F_Mask.gbr, Untitled-F_Paste.gbr]
2024-05-09 updated 5x5 square board... to do S2 staggering: flip along x instead of z axis and move horizontally
2024-05-10 added dimensions; thicker lines for grid to distinguish from dimensions
    [Untitled-B_Cu.gbr, Untitled-B_Mask.gbr, Untitled-B_Paste.gbr, Untitled-B_Silkscreen.gbr, Untitled-Edge_Cuts.gbr, Untitled-F_Cu.gbr, Untitled-F_Mask.gbr, Untitled-F_Paste.gbr]
2024-06-03 added 5x5 square board (even version), with edgecard connector
    [Untitled-B_Cu.gbr, Untitled-B_Mask.gbr, Untitled-B_Paste.gbr, Untitled-B_Silkscreen.gbr, Untitled-Edge_Cuts.gbr, Untitled-F_Cu.gbr, Untitled-F_Mask.gbr, Untitled-F_Paste.gbr]
2024-06-04 created odd-layer version of 5x5 board
    [Untitled-B_Cu.gbr, Untitled-B_Mask.gbr, Untitled-B_Paste.gbr, Untitled-B_Silkscreen.gbr, Untitled-Edge_Cuts.gbr, Untitled-F_Cu.gbr, Untitled-F_Mask.gbr, Untitled-F_Paste.gbr]
2024-06-17 added inverter board and dummy boards for the ZDC prototype test
    [Dummy Board-B_Cu.gbr, Dummy Board-B_Mask.gbr, Dummy Board-B_Paste.gbr, Dummy Board-B_Silkscreen.gbr, Dummy Board-Edge_Cuts.gbr, Dummy Board-F_Cu.gbr, Dummy Board-F_Mask.gbr, Dummy Board-F_Paste.gbr]
2024-06-17 dummy board with two edgecards
    [Dummy Board-B_Cu.gbr, Dummy Board-B_Mask.gbr, Dummy Board-B_Paste.gbr, Dummy Board-B_Silkscreen.gbr, Dummy Board-Edge_Cuts.gbr, Dummy Board-F_Cu.gbr, Dummy Board-F_Mask.gbr, Dummy Board-F_Paste.gbr]
2024-06-18 concentrator board for ZDC prototype test
    [Untitled-B_Cu.gbr, Untitled-B_Mask.gbr, Untitled-B_Paste.gbr, Untitled-B_Silkscreen.gbr, Untitled-Edge_Cuts.gbr, Untitled-F_Cu.gbr, Untitled-F_Mask.gbr, Untitled-F_Paste.gbr]
2024-06-20 new version of EvenLayers_1.3mm_SiPM
    [EvenLayers_1.3mm_SiPM-B_Cu.gbr, EvenLayers_1.3mm_SiPM-B_Mask.gbr, EvenLayers_1.3mm_SiPM-B_Paste.gbr, EvenLayers_1.3mm_SiPM-B_Silkscreen.gbr, EvenLayers_1.3mm_SiPM-Edge_Cuts.gbr, EvenLayers_1.3mm_SiPM-F_Cu.gbr, EvenLayers_1.3mm_SiPM-F_Mask.gbr, EvenLayers_1.3mm_SiPM-F_Paste.gbr]
2024-06-23 all combinations of even/odd 1.3 and 3.0 mm SiPMs
    [EvenLayers_3.0mm_SiPM-B_Cu.gbr, EvenLayers_3.0mm_SiPM-B_Mask.gbr, EvenLayers_3.0mm_SiPM-B_Paste.gbr, EvenLayers_3.0mm_SiPM-B_Silkscreen.gbr, EvenLayers_3.0mm_SiPM-Edge_Cuts.gbr, EvenLayers_3.0mm_SiPM-F_Cu.gbr, EvenLayers_3.0mm_SiPM-F_Mask.gbr, EvenLayers_3.0mm_SiPM-F_Paste.gbr]
2024-06-23 removed the deprecated version 3 of the ZDC prototype boards
    [Untitled-B_Cu.gbr, Untitled-B_Mask.gbr, Untitled-B_Paste.gbr, Untitled-B_Silkscreen.gbr, Untitled-Edge_Cuts.gbr, Untitled-F_Cu.gbr, Untitled-F_Mask.gbr, Untitled-F_Paste.gbr]
2024-06-27 new version of 3x3 6 mm SiPMs
    [3x3_6mSiPMs-B_Cu.gbr, 3x3_6mSiPMs-B_Mask.gbr, 3x3_6mSiPMs-B_Paste.gbr, 3x3_6mSiPMs-B_Silkscreen.gbr, 3x3_6mSiPMs-Edge_Cuts.gbr, 3x3_6mSiPMs-F_Cu.gbr, 3x3_6mSiPMs-F_Mask.gbr, 3x3_6mSiPMs-F_Paste.gbr]
2024-07-15 test board for 6 mm SiPM
    [Untitled-B_Cu.gbr, Untitled-B_Mask.gbr, Untitled-B_Paste.gbr, Untitled-B_Silkscreen.gbr, Untitled-Edge_Cuts.gbr, Untitled-F_Cu.gbr, Untitled-F_Mask.gbr, Untitled-F_Paste.gbr]
2024-07-16 added PrototypeSingleHexTileLarge_1.3mmSiPM
    [Untitled-B_Cu.gbr, Untitled-B_Mask.gbr, Untitled-B_Paste.gbr, Untitled-B_Silkscreen.gbr, Untitled-Edge_Cuts.gbr, Untitled-F_Cu.gbr, Untitled-F_Mask.gbr, Untitled-F_Paste.gbr]
2024-08-01 use 6050HS instead of 6015PS for single hex board
    [6.0mm.step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]
2024-08-01 updated odd layers 1.3 mm: correct size for the PCB board and tiles
    [OddLayers_1.3mm_SiPM-B_Cu.gbr, OddLayers_1.3mm_SiPM-B_Mask.gbr, OddLayers_1.3mm_SiPM-B_Paste.gbr, OddLayers_1.3mm_SiPM-B_Silkscreen.gbr, OddLayers_1.3mm_SiPM-Edge_Cuts.gbr, OddLayers_1.3mm_SiPM-F_Cu.gbr, OddLayers_1.3mm_SiPM-F_Mask.gbr, OddLayers_1.3mm_SiPM-F_Paste.gbr]
2024-08-01 updated 1.3 mm boards
    [EvenLayers_1.3mm_SiPM-B_Cu.gbr, EvenLayers_1.3mm_SiPM-B_Mask.gbr, EvenLayers_1.3mm_SiPM-B_Paste.gbr, EvenLayers_1.3mm_SiPM-B_Silkscreen.gbr, EvenLayers_1.3mm_SiPM-Edge_Cuts.gbr, EvenLayers_1.3mm_SiPM-F_Cu.gbr, EvenLayers_1.3mm_SiPM-F_Mask.gbr, EvenLayers_1.3mm_SiPM-F_Paste.gbr]
2024-08-05 fixed broken connections on 3x3 6mm SiPM board
    [3x3_6mSiPMs-B_Cu.gbr, 3x3_6mSiPMs-B_Mask.gbr, 3x3_6mSiPMs-B_Paste.gbr, 3x3_6mSiPMs-B_Silkscreen.gbr, 3x3_6mSiPMs-Edge_Cuts.gbr, 3x3_6mSiPMs-F_Cu.gbr, 3x3_6mSiPMs-F_Mask.gbr, 3x3_6mSiPMs-F_Paste.gbr]
2024-08-06 updated 1.3 mm SiPM board (single hex). Increased size of holes for the pogos
    [1.3mm.step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]
2024-08-06 removed an outdated step file
    [1.3mm.step]
2024-10-01 .gitignore: don't include backups automatically generated by KiCad
2024-10-01 version 5 of the 1.3 mm boards for the ZDC prototype
    [EvenLayers_1.3mm_SiPM-B_Cu.gbr, EvenLayers_1.3mm_SiPM-B_Mask.gbr, EvenLayers_1.3mm_SiPM-B_Paste.gbr, EvenLayers_1.3mm_SiPM-B_Silkscreen.gbr, EvenLayers_1.3mm_SiPM-Edge_Cuts.gbr, EvenLayers_1.3mm_SiPM-F_Cu.gbr, EvenLayers_1.3mm_SiPM-F_Mask.gbr, EvenLayers_1.3mm_SiPM-F_Paste.gbr]
2024-10-14 refactoring ZDC prototype to v6, which cycles through 4 different layers
    [EvenLayers_1.3mm_SiPM-B_Cu.gbr, EvenLayers_1.3mm_SiPM-B_Mask.gbr, EvenLayers_1.3mm_SiPM-B_Paste.gbr, EvenLayers_1.3mm_SiPM-B_Silkscreen.gbr, EvenLayers_1.3mm_SiPM-Edge_Cuts.gbr, EvenLayers_1.3mm_SiPM-F_Cu.gbr, EvenLayers_1.3mm_SiPM-F_Mask.gbr, EvenLayers_1.3mm_SiPM-F_Paste.gbr]
2024-11-20 added some boards that were not checked in previously
    [Dummy Board-B_Cu.gbr, Dummy Board-B_Mask.gbr, Dummy Board-B_Paste.gbr, Dummy Board-B_Silkscreen.gbr, Dummy Board-Edge_Cuts.gbr, Dummy Board-F_Cu.gbr, Dummy Board-F_Mask.gbr, Dummy Board-F_Paste.gbr]
2024-11-21 removed all traces of v6s
    [EvenLayers_1.3mm_SiPM-B_Cu.gbr, EvenLayers_1.3mm_SiPM-B_Mask.gbr, EvenLayers_1.3mm_SiPM-B_Paste.gbr, EvenLayers_1.3mm_SiPM-B_Silkscreen.gbr, EvenLayers_1.3mm_SiPM-Edge_Cuts.gbr, EvenLayers_1.3mm_SiPM-F_Cu.gbr, EvenLayers_1.3mm_SiPM-F_Mask.gbr, EvenLayers_1.3mm_SiPM-F_Paste.gbr]
2024-11-21 added v7
    [EvenLayers_1.3mm_SiPM-B_Cu.gbr, EvenLayers_1.3mm_SiPM-B_Mask.gbr, EvenLayers_1.3mm_SiPM-B_Paste.gbr, EvenLayers_1.3mm_SiPM-B_Silkscreen.gbr, EvenLayers_1.3mm_SiPM-Edge_Cuts.gbr, EvenLayers_1.3mm_SiPM-F_Cu.gbr, EvenLayers_1.3mm_SiPM-F_Mask.gbr, EvenLayers_1.3mm_SiPM-F_Paste.gbr]
2025-02-21 uploading Octagon board
    [OctagonPanels-B_Cu.gbr, OctagonPanels-B_Mask.gbr, OctagonPanels-B_Paste.gbr, OctagonPanels-B_Silkscreen.gbr, OctagonPanels-Edge_Cuts.gbr, OctagonPanels-F_Cu.gbr, OctagonPanels-F_Mask.gbr, OctagonPanels-F_Paste.gbr]
2025-02-21 updated documentation on board
    [OctagonPanels-B_Cu.gbr, OctagonPanels-B_Mask.gbr, OctagonPanels-B_Paste.gbr, OctagonPanels-B_Silkscreen.gbr, OctagonPanels-Edge_Cuts.gbr, OctagonPanels-F_Cu.gbr, OctagonPanels-F_Mask.gbr, OctagonPanels-F_Paste.gbr]
2025-02-24 concentrator board for octagon
    [ConcentratorBoardOctagon-B_Cu.gbr, ConcentratorBoardOctagon-B_Mask.gbr, ConcentratorBoardOctagon-B_Paste.gbr, ConcentratorBoardOctagon-B_Silkscreen.gbr, ConcentratorBoardOctagon-Edge_Cuts.gbr, ConcentratorBoardOctagon-F_Cu.gbr, ConcentratorBoardOctagon-F_Mask.gbr, ConcentratorBoardOctagon-F_Paste.gbr]
2025-02-26 v8 of ZDC boards
    [EvenLayers_1.3mm_SiPM-B_Cu.gbr, EvenLayers_1.3mm_SiPM-B_Mask.gbr, EvenLayers_1.3mm_SiPM-B_Paste.gbr, EvenLayers_1.3mm_SiPM-B_Silkscreen.gbr, EvenLayers_1.3mm_SiPM-Edge_Cuts.gbr, EvenLayers_1.3mm_SiPM-F_Cu.gbr, EvenLayers_1.3mm_SiPM-F_Mask.gbr, EvenLayers_1.3mm_SiPM-F_Paste.gbr]
2025-03-04 added custom footprints
2025-03-11 fixed version of even layers s v8
    [EvenLayers_1.3mm_SiPM-B_Cu.gbr, EvenLayers_1.3mm_SiPM-B_Mask.gbr, EvenLayers_1.3mm_SiPM-B_Paste.gbr, EvenLayers_1.3mm_SiPM-B_Silkscreen.gbr, EvenLayers_1.3mm_SiPM-Edge_Cuts.gbr, EvenLayers_1.3mm_SiPM-F_Cu.gbr, EvenLayers_1.3mm_SiPM-F_Mask.gbr, EvenLayers_1.3mm_SiPM-F_Paste.gbr]
2025-03-11 fixed version of odd layers v8
    [OddLayers_1.3mm_SiPM-B_Cu.gbr, OddLayers_1.3mm_SiPM-B_Mask.gbr, OddLayers_1.3mm_SiPM-B_Paste.gbr, OddLayers_1.3mm_SiPM-B_Silkscreen.gbr, OddLayers_1.3mm_SiPM-Edge_Cuts.gbr, OddLayers_1.3mm_SiPM-F_Cu.gbr, OddLayers_1.3mm_SiPM-F_Mask.gbr, OddLayers_1.3mm_SiPM-F_Paste.gbr]
